elatorre20/vstrom-ecu-reader/images/accelerometer.bmp

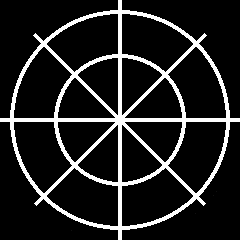
images/accelerometer.bmp
