elatorre20/vstrom-ecu-reader/images/canvas.bmp

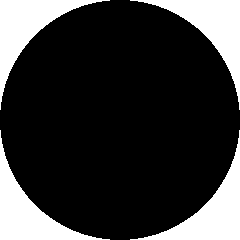
images/canvas.bmp
