elatorre20/vstrom-ecu-reader/images/temp_ring.png

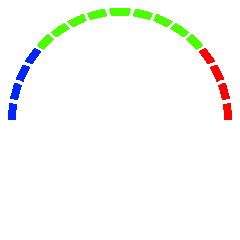
images/temp_ring.png
