elatorre20/vstrom-ecu-reader/test data/vstrom_test_sensors.txt

8012F1013EC280F112017E028012F1013EC280F112017E028012F1013EC280F112017E028012F101
3EC280F112017E028012F1013EC280F112017E028012F1005175657279696E672053656E736F7273
0D0A 

8012F1013EC280F112017E028012F1013EC280F112017E028012F1013EC280F112017E028012F101
3EC280F112017E028012F1013EC280F112017E028012F1005175657279696E672053656E736F7273
0D0A 

8012F1013EC280F112017E028012F1013EC280F112017E028012F1013EC280F112017E028012F101
3EC280F112017E028012F1013EC280F112017E028012F1005175657279696E672053656E736F7273
0D0A
