elatorre20/vstrom-ecu-reader/ecu_interface_v2_SH1106/images.h

//header for bitmap graphics


const unsigned char logo_splash[] PROGMEM = {
	0x00, 0x00, 0x00, 0x00, 0x00, 0x00, 0x00, 0x00, 0x00, 0x00, 0x00, 0x01, 0xc0, 0x00, 0x00, 0x00, 
	0x00, 0x00, 0x00, 0x03, 0xe0, 0x00, 0x00, 0x00, 0x00, 0x00, 0x00, 0x07, 0xf8, 0x00, 0x00, 0x00, 
	0x00, 0x00, 0x00, 0x0f, 0xfc, 0x00, 0x00, 0x00, 0x00, 0x00, 0x00, 0x1f, 0xfe, 0x00, 0x00, 0x00, 
	0x00, 0x00, 0x00, 0x3f, 0xff, 0x80, 0x00, 0x00, 0x00, 0x00, 0x00, 0xff, 0xff, 0xc0, 0x00, 0x00, 
	0x00, 0x00, 0x01, 0xff, 0xff, 0xf0, 0x00, 0x00, 0x00, 0x00, 0x03, 0xff, 0xff, 0xf8, 0x00, 0x00, 
	0x00, 0x00, 0x0f, 0xff, 0xff, 0xfc, 0x00, 0x00, 0x00, 0x00, 0x1f, 0xff, 0xff, 0xff, 0x00, 0x00, 
	0x00, 0x00, 0x7f, 0xff, 0xff, 0xff, 0x80, 0x00, 0x00, 0x00, 0xff, 0xff, 0xff, 0xff, 0xe0, 0x00, 
	0x00, 0x03, 0xff, 0xff, 0xff, 0xff, 0xf0, 0x00, 0x00, 0x0f, 0xfe, 0x3f, 0xff, 0xff, 0xf8, 0x00, 
	0x00, 0x3f, 0xfe, 0x0f, 0xff, 0xff, 0xfe, 0x00, 0x00, 0xff, 0xff, 0x07, 0xff, 0xff, 0xff, 0x00, 
	0x03, 0xff, 0xff, 0xc1, 0xff, 0xff, 0xff, 0xc0, 0x1f, 0xff, 0xff, 0xe0, 0xff, 0xff, 0xff, 0xe0, 
	0x3f, 0xff, 0xff, 0xf8, 0x3f, 0xff, 0xff, 0xf0, 0x0f, 0xff, 0xff, 0xfc, 0x1f, 0xff, 0xff, 0xfc, 
	0x07, 0xff, 0xff, 0xfe, 0x07, 0xff, 0xff, 0xfc, 0x01, 0xff, 0xff, 0xff, 0x81, 0xff, 0xff, 0xf8, 
	0x00, 0xff, 0xff, 0xff, 0xc0, 0xff, 0xff, 0xc0, 0x00, 0x3f, 0xff, 0xff, 0xf0, 0x3f, 0xff, 0x00, 
	0x00, 0x1f, 0xff, 0xff, 0xf8, 0x03, 0xe0, 0x00, 0x00, 0x07, 0xff, 0xff, 0xfe, 0x00, 0x00, 0x00, 
	0x00, 0x03, 0xff, 0xff, 0xff, 0x00, 0x00, 0x00, 0x00, 0x00, 0xff, 0xff, 0xff, 0x80, 0x00, 0x00, 
	0x00, 0x00, 0x7f, 0xff, 0xff, 0xe0, 0x00, 0x00, 0x00, 0x00, 0x3f, 0xff, 0xff, 0xf0, 0x00, 0x00, 
	0x00, 0x00, 0x0f, 0xff, 0xff, 0xfc, 0x00, 0x00, 0x00, 0x00, 0x07, 0xff, 0xff, 0xfe, 0x00, 0x00, 
	0x00, 0x00, 0x01, 0xff, 0xff, 0xff, 0x80, 0x00, 0x00, 0x00, 0x00, 0xff, 0xff, 0xff, 0xc0, 0x00, 
	0x00, 0x00, 0x00, 0x3f, 0xff, 0xff, 0xf0, 0x00, 0x00, 0x07, 0xe0, 0x1f, 0xff, 0xff, 0xf8, 0x00, 
	0x00, 0xff, 0xfc, 0x07, 0xff, 0xff, 0xfc, 0x00, 0x03, 0xff, 0xff, 0x03, 0xff, 0xff, 0xff, 0x00, 
	0x1f, 0xff, 0xff, 0xc1, 0xff, 0xff, 0xff, 0x80, 0x3f, 0xff, 0xff, 0xe0, 0x7f, 0xff, 0xff, 0xe0, 
	0x3f, 0xff, 0xff, 0xf8, 0x3f, 0xff, 0xff, 0xf0, 0x0f, 0xff, 0xff, 0xfc, 0x0f, 0xff, 0xff, 0xfc, 
	0x07, 0xff, 0xff, 0xff, 0x07, 0xff, 0xff, 0xf8, 0x01, 0xff, 0xff, 0xff, 0x81, 0xff, 0xff, 0xc0, 
	0x00, 0xff, 0xff, 0xff, 0xe0, 0xff, 0xff, 0x00, 0x00, 0x7f, 0xff, 0xff, 0xf0, 0x7f, 0xfc, 0x00, 
	0x00, 0x1f, 0xff, 0xff, 0xfc, 0x7f, 0xf0, 0x00, 0x00, 0x0f, 0xff, 0xff, 0xff, 0xff, 0xc0, 0x00, 
	0x00, 0x03, 0xff, 0xff, 0xff, 0xff, 0x80, 0x00, 0x00, 0x01, 0xff, 0xff, 0xff, 0xfe, 0x00, 0x00, 
	0x00, 0x00, 0x7f, 0xff, 0xff, 0xf8, 0x00, 0x00, 0x00, 0x00, 0x3f, 0xff, 0xff, 0xf0, 0x00, 0x00, 
	0x00, 0x00, 0x1f, 0xff, 0xff, 0xc0, 0x00, 0x00, 0x00, 0x00, 0x07, 0xff, 0xff, 0x80, 0x00, 0x00, 
	0x00, 0x00, 0x03, 0xff, 0xff, 0x00, 0x00, 0x00, 0x00, 0x00, 0x00, 0xff, 0xfe, 0x00, 0x00, 0x00, 
	0x00, 0x00, 0x00, 0x7f, 0xf8, 0x00, 0x00, 0x00, 0x00, 0x00, 0x00, 0x3f, 0xf0, 0x00, 0x00, 0x00, 
	0x00, 0x00, 0x00, 0x0f, 0xe0, 0x00, 0x00, 0x00, 0x00, 0x00, 0x00, 0x07, 0xc0, 0x00, 0x00, 0x00, 
	0x00, 0x00, 0x00, 0x01, 0x80, 0x00, 0x00, 0x00, 0x00, 0x00, 0x00, 0x00, 0x00, 0x00, 0x00, 0x00
};
