elatorre20/vstrom-ecu-reader/RP2040-LCD-1.28/c/examples/LCD_1in28_test.c

/*****************************************************************************
* | File      	:   LCD_1in28_test.c
* | Author      :   Waveshare team
* | Function    :   1.3inch LCD  test demo
* | Info        :
*----------------
* |	This version:   V1.0
* | Date        :   2021-08-20
* | Info        :
#
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
******************************************************************************/
#include "LCD_Test.h"
#include "LCD_1in28.h"
#include "QMI8658.h"
#include <stdio.h>
#include "pico/stdlib.h"
#include "hardware/adc.h"

int LCD_1in28_test(void)
{
    if (DEV_Module_Init() != 0)
    {
        return -1;
    }
    printf("LCD_1in28_test Demo\r\n");
    adc_init();
    adc_gpio_init(29);
    adc_select_input(3);
    /* LCD Init */
    printf("1.28inch LCD demo...\r\n");
    LCD_1IN28_Init(HORIZONTAL);
    LCD_1IN28_Clear(WHITE);
    DEV_SET_PWM(60);
    // LCD_SetBacklight(1023);
    UDOUBLE Imagesize = LCD_1IN28_HEIGHT * LCD_1IN28_WIDTH * 2;
    UWORD *BlackImage;
    if ((BlackImage = (UWORD *)malloc(Imagesize)) == NULL)
    {
        printf("Failed to apply for black memory...\r\n");
        exit(0);
    }
    // /*1.Create a new image cache named IMAGE_RGB and fill it with white*/
    Paint_NewImage((UBYTE *)BlackImage, LCD_1IN28.WIDTH, LCD_1IN28.HEIGHT, 0, WHITE);
    Paint_SetScale(65);
    Paint_Clear(WHITE);
    Paint_SetRotate(ROTATE_0);
    Paint_Clear(WHITE);

    // /* GUI */
    printf("drawing...\r\n");
    // /*2.Drawing on the image*/
#if 1
    Paint_DrawPoint(50, 41, BLACK, DOT_PIXEL_1X1, DOT_FILL_RIGHTUP); // 240 240
    Paint_DrawPoint(50, 46, BLACK, DOT_PIXEL_2X2, DOT_FILL_RIGHTUP);
    Paint_DrawPoint(50, 51, BLACK, DOT_PIXEL_3X3, DOT_FILL_RIGHTUP);
    Paint_DrawPoint(50, 56, BLACK, DOT_PIXEL_4X4, DOT_FILL_RIGHTUP);
    Paint_DrawPoint(50, 61, BLACK, DOT_PIXEL_5X5, DOT_FILL_RIGHTUP);

    Paint_DrawLine(60, 40, 90, 70, MAGENTA, DOT_PIXEL_2X2, LINE_STYLE_SOLID);
    Paint_DrawLine(60, 70, 90, 40, MAGENTA, DOT_PIXEL_2X2, LINE_STYLE_SOLID);

    Paint_DrawRectangle(60, 40, 90, 70, RED, DOT_PIXEL_2X2, DRAW_FILL_EMPTY);
    Paint_DrawRectangle(100, 40, 130, 70, BLUE, DOT_PIXEL_2X2, DRAW_FILL_FULL);

    Paint_DrawLine(135, 55, 165, 55, CYAN, DOT_PIXEL_1X1, LINE_STYLE_DOTTED);
    Paint_DrawLine(150, 40, 150, 70, CYAN, DOT_PIXEL_1X1, LINE_STYLE_DOTTED);

    Paint_DrawCircle(150, 55, 15, GREEN, DOT_PIXEL_1X1, DRAW_FILL_EMPTY);
    Paint_DrawCircle(185, 55, 15, GREEN, DOT_PIXEL_1X1, DRAW_FILL_FULL);

    Paint_DrawNum(50, 80, 9.87654321, &Font20, 3, WHITE, BLACK);
    Paint_DrawString_EN(50, 100, "ABC", &Font20, 0x000f, 0xfff0);
    Paint_DrawString_CN(50, 120, "欢迎使用", &Font24CN, WHITE, BLUE);
    Paint_DrawString_EN(50, 161, "WaveShare", &Font16, RED, WHITE);

    // /*3.Refresh the picture in RAM to LCD*/
    LCD_1IN28_Display(BlackImage);
    DEV_Delay_ms(1000);

#endif
#if 1
    Paint_DrawImage(gImage_1inch3_1, 0, 0, 240, 240);
    LCD_1IN28_Display(BlackImage);
    DEV_Delay_ms(1000);
#endif

#if 1

    float acc[3], gyro[3];
    unsigned int tim_count = 0;
    QMI8658_init();
    printf("QMI8658_init\r\n");

    while (true)
    {
        const float conversion_factor = 3.3f / (1 << 12) * 2;
        uint16_t result = adc_read();
        printf("Raw value: 0x%03x, voltage: %f V\n", result, result * conversion_factor);
        Paint_Clear(WHITE);
        QMI8658_read_xyz(acc, gyro, &tim_count);
        printf("acc_x   = %4.3fmg , acc_y  = %4.3fmg , acc_z  = %4.3fmg\r\n", acc[0], acc[1], acc[2]);
        printf("gyro_x  = %4.3fdps, gyro_y = %4.3fdps, gyro_z = %4.3fdps\r\n", gyro[0], gyro[1], gyro[2]);

        printf("tim_count = %d\r\n", tim_count);
        Paint_DrawString_EN(30, 50, "ACC_X = ", &Font16, WHITE, BLACK);
        Paint_DrawString_EN(30, 75, "ACC_Y = ", &Font16, WHITE, BLACK);
        Paint_DrawString_EN(30, 100, "ACC_Z = ", &Font16, WHITE, BLACK);
        Paint_DrawString_EN(30, 125, "GYR_X = ", &Font16, WHITE, BLACK);
        Paint_DrawString_EN(30, 150, "GYR_Y = ", &Font16, WHITE, BLACK);
        Paint_DrawString_EN(30, 175, "GYR_Z = ", &Font16, WHITE, BLACK);
        Paint_DrawString_EN(30, 175, "GYR_Z = ", &Font16, WHITE, BLACK);
        Paint_DrawNum(120, 50, acc[0], &Font16, 2, BLACK, WHITE);
        Paint_DrawNum(120, 75, acc[1], &Font16, 2, BLACK, WHITE);
        Paint_DrawNum(120, 100, acc[2], &Font16, 2, BLACK, WHITE);
        Paint_DrawNum(120, 125, gyro[0], &Font16, 2, BLACK, WHITE);
        Paint_DrawNum(120, 150, gyro[1], &Font16, 2, BLACK, WHITE);
        Paint_DrawNum(120, 175, gyro[2], &Font16, 2, BLACK, WHITE);
        Paint_DrawString_EN(50, 200, "BAT(V)=", &Font16, WHITE, BLACK);
        Paint_DrawNum(130, 200, result * conversion_factor, &Font16, 2, BLACK, WHITE);

        LCD_1IN28_Display(BlackImage);
        DEV_Delay_ms(100);
    }

#endif

    /* Module Exit */
    free(BlackImage);
    BlackImage = NULL;

    DEV_Module_Exit();
    return 0;
}
