elatorre20/vstrom-ecu-reader/(commit log)

2023-05-11 started on circuit diagram
    [vstrom_ecu_reader.kicad_pcb, vstrom_ecu_reader.kicad_sch]
2023-06-25 sprite graphics working
    Completed toolchain for creating bitmap sprites and displaying them on the screen. Started on sprites for gear indicators.
2023-06-25 added all gear and temperature sprites
2023-06-27 finished temperature sprite coding
    Coded temperature sprite bitmaps and placement. Very tedious.
2023-06-29 fixed positions of temp display segments
    [ecu_interface.ino]
2023-06-29 All display logic finished
    All sprites and main-loop checks for displaying gear and temperature are finished.
2023-07-03 Switched to timer ISR scheduling
    Implemented scheduling for display update and ECU communication tasks using timer interrupts for non-blocking delay.
2023-07-04 beginning work on accelerometer mode
    Added images for accelerometer mode. Did some timing analysis on the display task.
2023-07-04 finished accelerometer
    Accelerometer displaying correctly. Gravity adjustment values will have to be calibrated once mounted on the motorcycle.
    [ecu_interface.ino]
2023-07-13 switched to acceleration adjustment
    Now compensating for orientation by adjusting accelerometer readings directly instead of pixel values.
2023-10-24 switching to a micro with SSD1306
2023-10-31 Timer interrupt working
    Set up timer interrupt using registers instead of library to save 2kb of flash
2023-10-31 Gear bitmaps working
    Gear bitmaps displaying correctly. Flash use for bitmaps at an acceptable level.
    [ecu_interface_v2.ino, images.h]
2023-11-02 Switching to text-based graphics
    Replaced bitmap images with character graphics to save program memory
    [ecu_interface_v2.ino, images.h]
2023-11-05 Working on UART
2023-11-05 Fixed sending arrays from progmem
    [serial_sender.ino]
2023-11-08 small updates and experiments with logic analyzer
    Added switch for command parsing,
    corrected init sequence for suzuki KWP2000 implementation, corrected bug in display
    [serial_sender.ino]
2023-11-09 Added further commands
    Added commands for quit, clear DTC, and query sensors. Added periodic keepalive messages.
2023-11-13 First successful connection with bike
    Rewired board to bring logic high voltage within range. First successful interface with the running motorcycle. Captured logic analyzer sessions of sensor dumps from testing.
2023-11-13 Updated read and parse
    Updated UART read to reflect ECU response timing. Started on parser for stats.
2023-11-20 Gear display working correctly
    Arduino successfully establishes and retains communication with ECU. Final query and display logic for gears is finished. Eliminated keepalives by increasing update frequency.
    [ecu_interface_v2.ino, serial_sender.ino]
2023-11-24 Added temperature sensor
    Added DHT11 for reading ambient temperature and printing to screen.
2024-03-03 Move to SH1106 screen
    I bought a new screen after breaking the old one that uses an SH1106 driver instead of an SSD1306. I included two sketches for compatibility to allow either screen to be used
